Darpan1012/16-channel-manual-variable-power-supply-circuit/README.md

16 channel 0-15 V dual supply power source circuit
