Darpan1012/16-channel-manual-variable-power-supply-circuit/Schematic/GBR_10043463_1_bottom.png

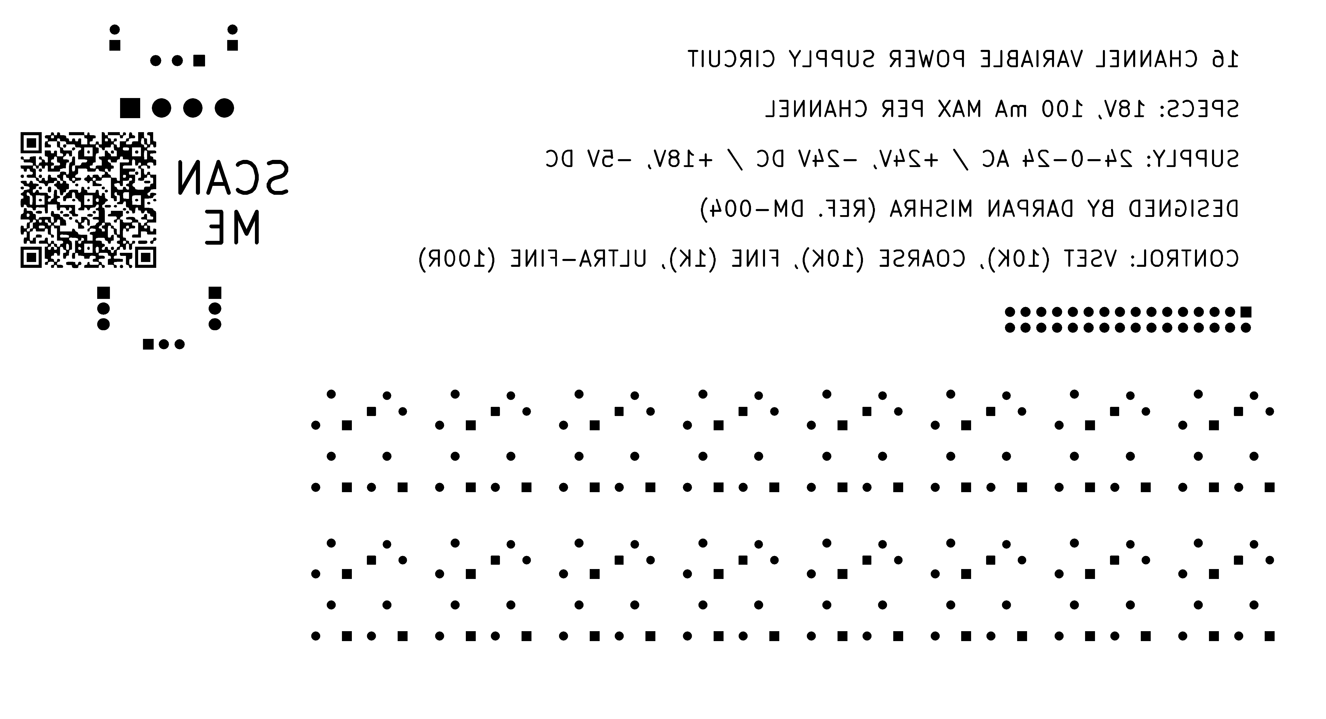
Schematic/GBR_10043463_1_bottom.png
