Darpan1012/16-channel-manual-variable-power-supply-circuit/Schematic/power supply circuit schematic.PNG

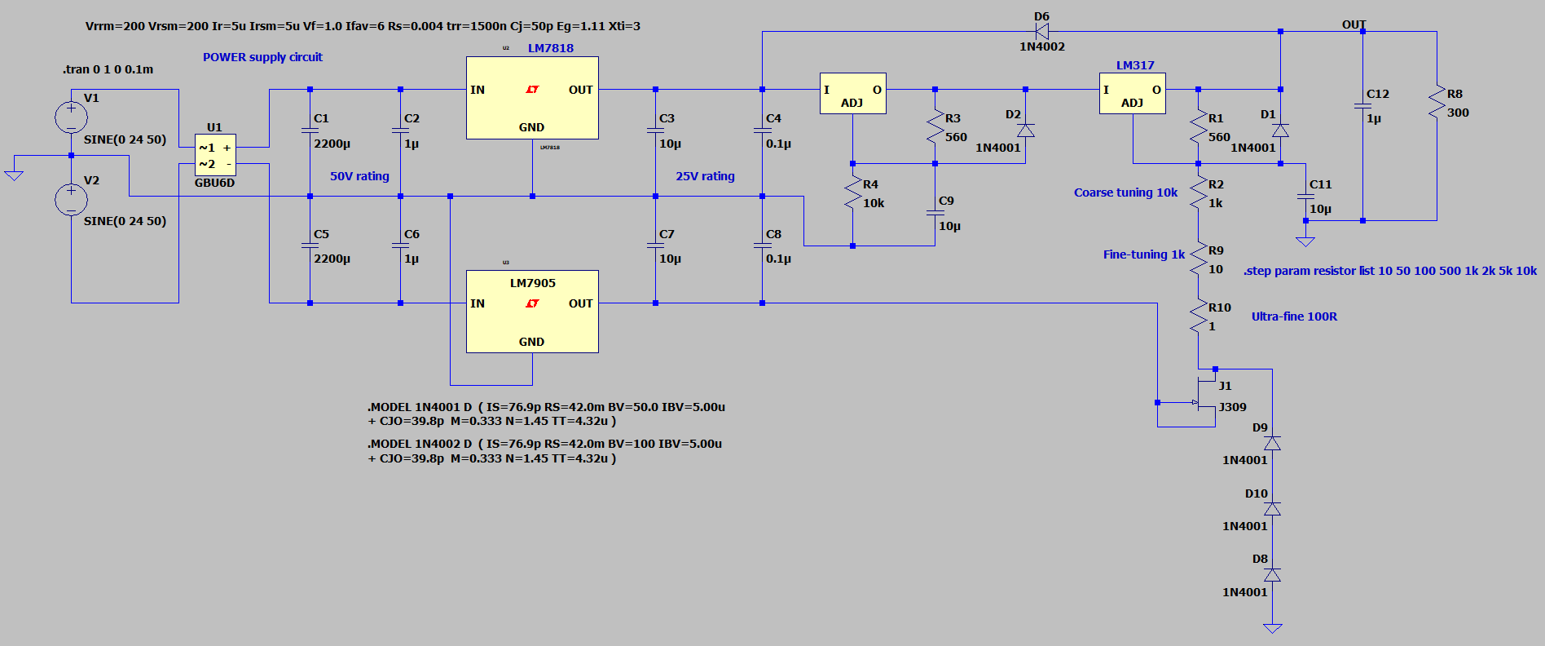
Schematic/power supply circuit schematic.PNG
