Darpan1012/16-channel-manual-variable-power-supply-circuit/Schematic/Snapshot.png

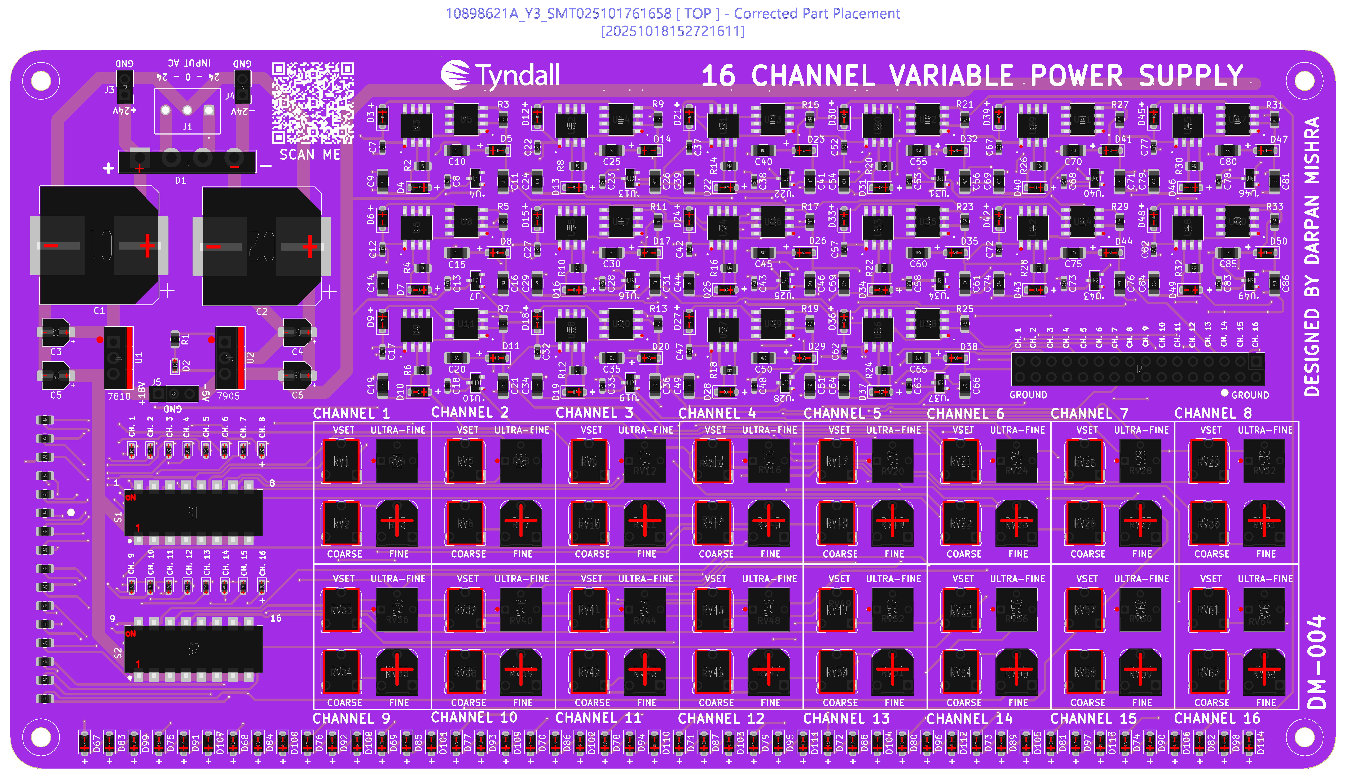
Schematic/Snapshot.png
