Darpan1012/16-channel-manual-variable-power-supply-circuit/SPICE/Power source circuit.asc

C1: cap; 2200µ; V=50 Irms=1.53 Rser=0.037 Lser=0 mfg="Nichicon" pn="UPR1H222MRH" type="Al electrolytic"
C2: cap; 1µ; V=50 Irms=0 Rser=0.0444 Lser=799p mfg="Würth Elektronik" pn="885012209047 WCAP-CSGP 1210" type="X7R"
C3: cap; 10µ; V=25 Irms=23m Rser=1.95 Lser=70f mfg="Würth Elektronik" pn="865230440002 WCAP-AS5H 4.3x4.3" type="Al electrolytic"
C4: cap; 0.1µ; V=25 Irms=0 Rser=0.0287 Lser=150p mfg="Würth Elektronik" pn="885012104005 WCAP-CSGP 0201" type="X5R"
C5: cap; 2200µ; V=50 Irms=1.53 Rser=0.037 Lser=0 mfg="Nichicon" pn="UPR1H222MRH" type="Al electrolytic"
C6: cap; 1µ; V=50 Irms=0 Rser=0.0444 Lser=799p mfg="Würth Elektronik" pn="885012209047 WCAP-CSGP 1210" type="X7R"
C7: cap; 10µ; V=25 Irms=23m Rser=1.95 Lser=70f mfg="Würth Elektronik" pn="865230440002 WCAP-AS5H 4.3x4.3" type="Al electrolytic"
C8: cap; 0.1µ; V=25 Irms=0 Rser=0.0287 Lser=150p mfg="Würth Elektronik" pn="885012104005 WCAP-CSGP 0201" type="X5R"
C9: cap; 10µ; V=25 Irms=23m Rser=1.95 Lser=70f mfg="Würth Elektronik" pn="865230440002 WCAP-AS5H 4.3x4.3" type="Al electrolytic"
C11: cap; 10µ; V=25 Irms=23m Rser=1.95 Lser=70f mfg="Würth Elektronik" pn="865230440002 WCAP-AS5H 4.3x4.3" type="Al electrolytic"
C12: cap; 1µ; V=25 Irms=0 Rser=0.014 Lser=1000p mfg="Würth Elektronik" pn="885012210012 WCAP-CSGP 1812" type="X7R"
D1: diode; 1N4001
D2: diode; 1N4001
D6: diode; 1N4002
D8: diode; 1N4001
D9: diode; 1N4001
D10: diode; 1N4001
J1: njf; J309
R1: res; 560
R2: res; 1k
R3: res; 560
R4: res; 10k
R8: res; 300
R9: res; 10
R10: res; 1
U1: gbu6d
U2: 7818
U3: 7905
U4: LM317
U5: LM317
V1: voltage; SINE(0 24 50)
V2: voltage; SINE(0 24 50)
Named nets: 0, OUT
LM7818
.tran 0 1 0 0.1m
50V rating
25V rating
POWER supply circuit
.MODEL 1N4001 D  ( IS=76.9p RS=42.0m BV=50.0 IBV=5.00u
+ CJO=39.8p  M=0.333 N=1.45 TT=4.32u )
.MODEL 1N4002 D  ( IS=76.9p RS=42.0m BV=100 IBV=5.00u
+ CJO=39.8p  M=0.333 N=1.45 TT=4.32u )
.step param resistor list 10 50 100 500 1k 2k 5k 10k
LM317
Fine-tuning 1k
Ultra-fine 100R
Coarse tuning 10k
