Darpan1012/16-channel-manual-variable-power-supply-circuit/Kicad/power_source_16_ch_manual_ver_4.kicad_pcb

## KiCad design Kicad/power_source_16_ch_manual_ver_4.kicad_pcb (2025-11-14)

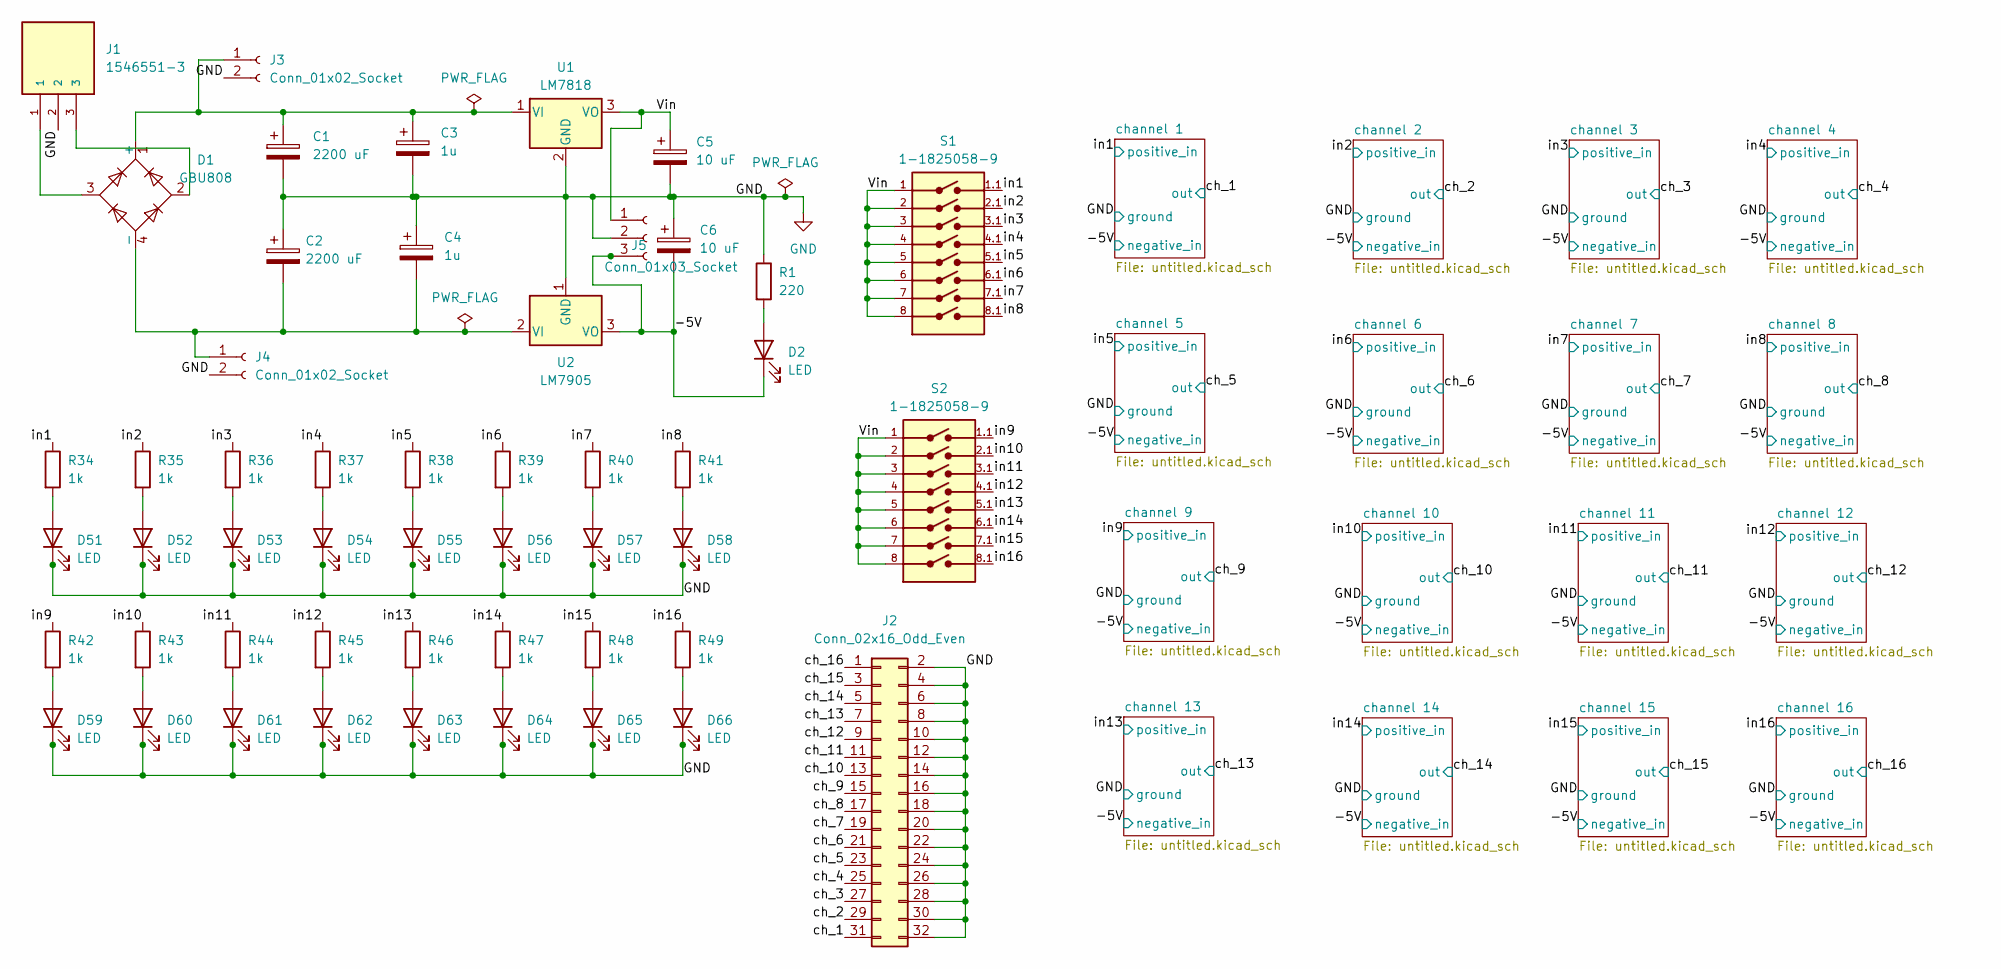
[picture p6: schematic power_source_16_ch_manual_ver_4.kicad_sch, 16 channel manual driver (0-15V)]

Parts:
C1, C2: 2200 uF; CP_Elec_18x17.5; Part Number VE-222M1VTR-1816; LCSC PN C249505
C3, C4: 1u; CP_Elec_4x5.4; Part Number RVT1H1R0M0405; LCSC PN C3348
C5, C6: 10 uF; CP_Elec_4x5.4; Part Number RVT1E100M0405; LCSC PN C3343
D1: GBU808; Diode_Bridge_Vishay_GBU; Part Number GBU808; LCSC PN C3072
D2, D51, D52, D53, D54, D55, D56, D57, D58, D59, D60, D61, D62, D63, D64, D65, D66: LED; LED_0603_1608Metric; Part Number KT-0603R; LCSC PN C2286
J1: 1546551-3; TE_1546551-3; PARTREV R
J2: Conn_02x16_Odd_Even; PinHeader_2x16_P2.54mm_Vertical; Part Number DS1023-2*16SF11; LCSC PN C132130
J3, J4: Conn_01x02_Socket; PinHeader_1x02_P2.54mm_Vertical; Part Number DS1023-1x2SF11; LCSC PN C7509512
J5: Conn_01x03_Socket; PinHeader_1x03_P2.54mm_Vertical; Part Number DS1023-1x3SF11; LCSC PN C7509516
R1: 220; R_0805_2012Metric; Part Number 0805W8F2200T5E; LCSC PN C17557
R34, R35, R36, R37, R38, R39, R40, R41, R42, R43, R44, R45, R46, R47, R48, R49: 1k; R_0805_2012Metric; Part Number 0805W8F1001T5E; LCSC PN C17513
S1, S2: 1-1825058-9; SW_1-1825058-9; PARTREV S4; LCSC PN C266184
U1: LM7818; TO-220-3_Vertical; Part Number L7818CV-DG; LCSC PN C15411
U2: LM7905; TO-220-3_Vertical; Part Number L7905CV-DG; LCSC PN C3799

Connections:
/-5V: C6.2, D2.1 (K), J5.3, U2.3 (VO); also elsewhere on the board
/Vin: C5.1, J5.1, S1.1, S1.2, S1.3, S1.4, S1.5, S1.6, S1.7, S1.8, S2.1, S2.2, S2.3, S2.4, S2.5, S2.6, S2.7, S2.8, U1.3 (VO)
/ch_1: J2.31; also elsewhere on the board
/ch_2: J2.29; also elsewhere on the board
/ch_3: J2.27; also elsewhere on the board
/ch_4: J2.25; also elsewhere on the board
/ch_5: J2.23; also elsewhere on the board
/ch_6: J2.21; also elsewhere on the board
/ch_7: J2.19; also elsewhere on the board
/ch_8: J2.17; also elsewhere on the board
/ch_9: J2.15; also elsewhere on the board
/ch_10: J2.13; also elsewhere on the board
/ch_11: J2.11; also elsewhere on the board
/ch_12: J2.9; also elsewhere on the board
/ch_13: J2.7; also elsewhere on the board
/ch_14: J2.5; also elsewhere on the board
/ch_15: J2.3; also elsewhere on the board
/ch_16: J2.1; also elsewhere on the board
/in1: R34.1, S1.1.1; also elsewhere on the board
/in2: R35.1, S1.2.1; also elsewhere on the board
/in3: R36.1, S1.3.1; also elsewhere on the board
/in4: R37.1, S1.4.1; also elsewhere on the board
/in5: R38.1, S1.5.1; also elsewhere on the board
/in6: R39.1, S1.6.1; also elsewhere on the board
/in7: R40.1, S1.7.1; also elsewhere on the board
/in8: R41.1, S1.8.1; also elsewhere on the board
/in9: R42.1, S2.1.1; also elsewhere on the board
/in10: R43.1, S2.2.1; also elsewhere on the board
/in11: R44.1, S2.3.1; also elsewhere on the board
/in12: R45.1, S2.4.1; also elsewhere on the board
/in13: R46.1, S2.5.1; also elsewhere on the board
/in14: R47.1, S2.6.1; also elsewhere on the board
/in15: R48.1, S2.7.1; also elsewhere on the board
/in16: R49.1, S2.8.1; also elsewhere on the board
GND: C1.2, C2.1, C3.2, C4.1, C5.2, C6.1, D51.1 (K), D52.1 (K), D53.1 (K), D54.1 (K), D55.1 (K), D56.1 (K), D57.1 (K), D58.1 (K), D59.1 (K), D60.1 (K), D61.1 (K), D62.1 (K), D63.1 (K), D64.1 (K), D65.1 (K), D66.1 (K), J1.2, J2.2, J2.4, J2.6, J2.8, J2.10, J2.12, J2.14, J2.16, J2.18, J2.20, J2.22, J2.24, J2.26, J2.28, J2.30, J2.32, J3.2, J4.2, J5.2, R1.1, U1.2 (GND), U2.1 (GND); also elsewhere on the board
unnamed: C1.1, C3.1, D1.1 (+), J3.1, U1.1 (VI)
unnamed: C2.2, C4.2, D1.4 (-), J4.1, U2.2 (VI)
unnamed: D1.2, J1.3
unnamed: D1.3, J1.1
unnamed: D2.2 (A), R1.2
unnamed: D51.2 (A), R34.2
unnamed: D52.2 (A), R35.2
unnamed: D53.2 (A), R36.2
unnamed: D54.2 (A), R37.2
unnamed: D55.2 (A), R38.2
unnamed: D56.2 (A), R39.2
unnamed: D57.2 (A), R40.2
unnamed: D58.2 (A), R41.2
unnamed: D59.2 (A), R42.2
unnamed: D60.2 (A), R43.2
unnamed: D61.2 (A), R44.2
unnamed: D62.2 (A), R45.2
unnamed: D63.2 (A), R46.2
unnamed: D64.2 (A), R47.2
unnamed: D65.2 (A), R48.2
unnamed: D66.2 (A), R49.2

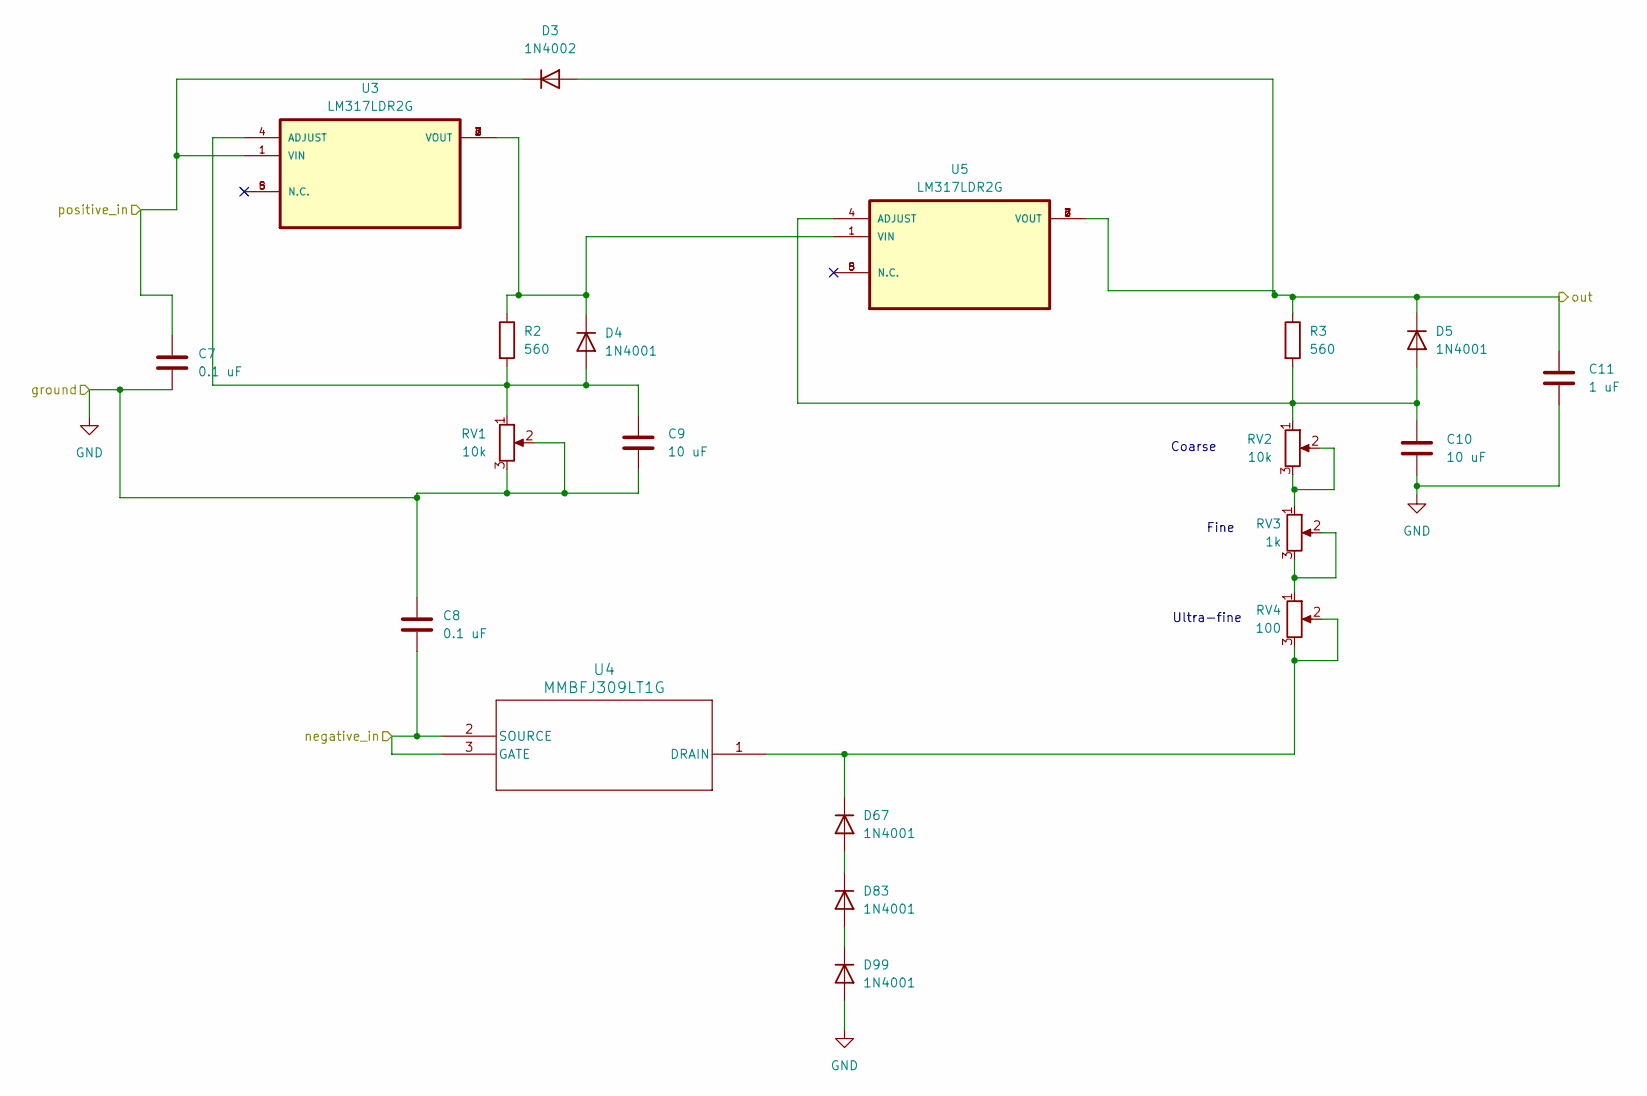
[picture p7: schematic untitled.kicad_sch, channel]

Parts:
C7, C8: 0.1 uF; C_0603_1608Metric; Part Number CC0603KRX7R9BB104; LCSC PN C14663
C9, C10: 10 uF; C_1206_3216Metric; Part Number CL31A106KBHNNNE; LCSC PN C13585
C11: 1 uF; C_1206_3216Metric; Part Number CL31B105KBHNNNE; LCSC PN C1848
D3: 1N4002; D_SOD-123F; Part Number 1N4002W; LCSC PN C169542
D4, D5, D67, D83, D99: 1N4001; D_SOD-123F; Part Number 1N4001W; LCSC PN C162732
R2, R3: 560; R_0805_2012Metric; Part Number 0805W8F5600T5E; LCSC PN C28636
RV1, RV2: 10k; Potentiometer_Runtron_RM-065_Vertical; Part Number WH06-2C-103(10K); LCSC PN C5205043
RV3: 1k; Potentiometer_Runtron_RM-065_Vertical; Part Number WH06-2C-102(1K); LCSC PN C5205040
RV4: 100; TRIM_3362P-1-103; Part Number 3362P-1-101; LCSC PN C118959
U3, U5: LM317LDR2G; SOIC127P600X175-8N; Part Number LM317LD13TR; LCSC PN C81457
U4: MMBFJ309LT1G; SOT-23_ONS-L; Part Number MMBFJ309LT1G; LCSC PN C58012

Connections:
/-5V: C8.2, U4.2 (SOURCE), U4.3 (GATE); also elsewhere on the board
/ch_1: C11.1, D3.2 (A), D5.1 (K), R3.1, U5.2 (VOUT), U5.3 (VOUT), U5.6 (VOUT), U5.7 (VOUT); also elsewhere on the board
/in1: C7.1, D3.1 (K), U3.1 (VIN); also elsewhere on the board
GND: C7.2, C8.1, C9.2, C10.2, C11.2, D99.2 (A), RV1.2, RV1.3; also elsewhere on the board
unnamed: C9.1, D4.2 (A), R2.2, RV1.1, U3.4 (ADJUST)
unnamed: D4.1 (K), R2.1, U3.2 (VOUT), U3.3 (VOUT), U3.6 (VOUT), U3.7 (VOUT), U5.1 (VIN)
unnamed: C10.1, D5.2 (A), R3.2, RV2.1, U5.4 (ADJUST)
unnamed: D67.2 (A), D83.1 (K)
unnamed: D67.1 (K), RV4.2, RV4.3, U4.1 (DRAIN)
unnamed: D83.2 (A), D99.1 (K)
unnamed: RV2.2, RV2.3, RV3.1
unnamed: RV3.2, RV3.3, RV4.1

Parts of its further copies:
C12, C13, C17, C18, C22, C23, C27, C28, C32, C33, C37, C38, C42, C43, C47, C48, C52, C53, C57, C58, C62, C63, C67, C68, C72, C73, C77, C78, C82, C83: 0.1 uF; C_0603_1608Metric; Part Number CC0603KRX7R9BB104; LCSC PN C14663
C14, C15, C19, C20, C24, C25, C29, C30, C34, C35, C39, C40, C44, C45, C49, C50, C54, C55, C59, C60, C64, C65, C69, C70, C74, C75, C79, C80, C84, C85: 10 uF; C_1206_3216Metric; Part Number CL31A106KBHNNNE; LCSC PN C13585
C16, C21, C26, C31, C36, C41, C46, C51, C56, C61, C66, C71, C76, C81, C86: 1 uF; C_1206_3216Metric; Part Number CL31B105KBHNNNE; LCSC PN C1848
D6, D9, D12, D15, D18, D21, D24, D27, D30, D33, D36, D39, D42, D45, D48: 1N4002; D_SOD-123F; Part Number 1N4002W; LCSC PN C169542
D7, D8, D10, D11, D13, D14, D16, D17, D19, D20, D22, D23, D25, D26, D28, D29, D31, D32, D34, D35, D37, D38, D40, D41, D43, D44, D46, D47, D49, D50, D68, D69, D70, D71, D72, D73, D74, D75, D76, D77, D78, D79, D80, D81, D82, D84, D85, D86, D87, D88, D89, D90, D91, D92, D93, D94, D95, D96, D97, D98, D100, D101, D102, D103, D104, D105, D106, D107, D108, D109, D110, D111, D112, D113, D114: 1N4001; D_SOD-123F; Part Number 1N4001W; LCSC PN C162732
R4, R5, R6, R7, R8, R9, R10, R11, R12, R13, R14, R15, R16, R17, R18, R19, R20, R21, R22, R23, R24, R25, R26, R27, R28, R29, R30, R31, R32, R33: 560; R_0805_2012Metric; Part Number 0805W8F5600T5E; LCSC PN C28636
RV5, RV6, RV9, RV10, RV13, RV14, RV17, RV18, RV21, RV22, RV25, RV26, RV29, RV30, RV33, RV34, RV37, RV38, RV41, RV42, RV45, RV46, RV49, RV50, RV53, RV54, RV57, RV58, RV61, RV62: 10k; Potentiometer_Runtron_RM-065_Vertical; Part Number WH06-2C-103(10K); LCSC PN C5205043
RV7, RV11, RV15, RV19, RV23, RV27, RV31, RV35, RV39, RV43, RV47, RV51, RV55, RV59, RV63: 1k; Potentiometer_Runtron_RM-065_Vertical; Part Number WH06-2C-102(1K); LCSC PN C5205040
RV8, RV12, RV16, RV20, RV24, RV28, RV32, RV36, RV40, RV44, RV48, RV52, RV56, RV60, RV64: 100; TRIM_3362P-1-103; Part Number 3362P-1-101; LCSC PN C118959
U6, U8, U9, U11, U12, U14, U15, U17, U18, U20, U21, U23, U24, U26, U27, U29, U30, U32, U33, U35, U36, U38, U39, U41, U42, U44, U45, U47, U48, U50: LM317LDR2G; SOIC127P600X175-8N; Part Number LM317LD13TR; LCSC PN C81457
U7, U10, U13, U16, U19, U22, U25, U28, U31, U34, U37, U40, U43, U46, U49: MMBFJ309LT1G; SOT-23_ONS-L; Part Number MMBFJ309LT1G; LCSC PN C58012

Connections of its further copies:
/-5V: C13.2, C18.2, C23.2, C28.2, C33.2, C38.2, C43.2, C48.2, C53.2, C58.2, C63.2, C68.2, C73.2, C78.2, C83.2, U7.2 (SOURCE), U7.3 (GATE), U10.2 (SOURCE), U10.3 (GATE), U13.2 (SOURCE), U13.3 (GATE), U16.2 (SOURCE), U16.3 (GATE), U19.2 (SOURCE), U19.3 (GATE), U22.2 (SOURCE), U22.3 (GATE), U25.2 (SOURCE), U25.3 (GATE), U28.2 (SOURCE), U28.3 (GATE), U31.2 (SOURCE), U31.3 (GATE), U34.2 (SOURCE), U34.3 (GATE), U37.2 (SOURCE), U37.3 (GATE), U40.2 (SOURCE), U40.3 (GATE), U43.2 (SOURCE), U43.3 (GATE), U46.2 (SOURCE), U46.3 (GATE), U49.2 (SOURCE), U49.3 (GATE); also elsewhere on the board
/ch_2: C16.1, D6.2 (A), D8.1 (K), R5.1, U8.2 (VOUT), U8.3 (VOUT), U8.6 (VOUT), U8.7 (VOUT); also elsewhere on the board
/ch_3: C21.1, D9.2 (A), D11.1 (K), R7.1, U11.2 (VOUT), U11.3 (VOUT), U11.6 (VOUT), U11.7 (VOUT); also elsewhere on the board
/ch_4: C26.1, D12.2 (A), D14.1 (K), R9.1, U14.2 (VOUT), U14.3 (VOUT), U14.6 (VOUT), U14.7 (VOUT); also elsewhere on the board
/ch_5: C31.1, D15.2 (A), D17.1 (K), R11.1, U17.2 (VOUT), U17.3 (VOUT), U17.6 (VOUT), U17.7 (VOUT); also elsewhere on the board
/ch_6: C36.1, D18.2 (A), D20.1 (K), R13.1, U20.2 (VOUT), U20.3 (VOUT), U20.6 (VOUT), U20.7 (VOUT); also elsewhere on the board
/ch_7: C41.1, D21.2 (A), D23.1 (K), R15.1, U23.2 (VOUT), U23.3 (VOUT), U23.6 (VOUT), U23.7 (VOUT); also elsewhere on the board
/ch_8: C46.1, D24.2 (A), D26.1 (K), R17.1, U26.2 (VOUT), U26.3 (VOUT), U26.6 (VOUT), U26.7 (VOUT); also elsewhere on the board
/ch_9: C51.1, D27.2 (A), D29.1 (K), R19.1, U29.2 (VOUT), U29.3 (VOUT), U29.6 (VOUT), U29.7 (VOUT); also elsewhere on the board
/ch_10: C56.1, D30.2 (A), D32.1 (K), R21.1, U32.2 (VOUT), U32.3 (VOUT), U32.6 (VOUT), U32.7 (VOUT); also elsewhere on the board
/ch_11: C61.1, D33.2 (A), D35.1 (K), R23.1, U35.2 (VOUT), U35.3 (VOUT), U35.6 (VOUT), U35.7 (VOUT); also elsewhere on the board
/ch_12: C66.1, D36.2 (A), D38.1 (K), R25.1, U38.2 (VOUT), U38.3 (VOUT), U38.6 (VOUT), U38.7 (VOUT); also elsewhere on the board
/ch_13: C71.1, D39.2 (A), D41.1 (K), R27.1, U41.2 (VOUT), U41.3 (VOUT), U41.6 (VOUT), U41.7 (VOUT); also elsewhere on the board
/ch_14: C76.1, D42.2 (A), D44.1 (K), R29.1, U44.2 (VOUT), U44.3 (VOUT), U44.6 (VOUT), U44.7 (VOUT); also elsewhere on the board
/ch_15: C81.1, D45.2 (A), D47.1 (K), R31.1, U47.2 (VOUT), U47.3 (VOUT), U47.6 (VOUT), U47.7 (VOUT); also elsewhere on the board
/ch_16: C86.1, D48.2 (A), D50.1 (K), R33.1, U50.2 (VOUT), U50.3 (VOUT), U50.6 (VOUT), U50.7 (VOUT); also elsewhere on the board
/in2: C12.1, D6.1 (K), U6.1 (VIN); also elsewhere on the board
/in3: C17.1, D9.1 (K), U9.1 (VIN); also elsewhere on the board
/in4: C22.1, D12.1 (K), U12.1 (VIN); also elsewhere on the board
/in5: C27.1, D15.1 (K), U15.1 (VIN); also elsewhere on the board
/in6: C32.1, D18.1 (K), U18.1 (VIN); also elsewhere on the board
/in7: C37.1, D21.1 (K), U21.1 (VIN); also elsewhere on the board
/in8: C42.1, D24.1 (K), U24.1 (VIN); also elsewhere on the board
/in9: C47.1, D27.1 (K), U27.1 (VIN); also elsewhere on the board
/in10: C52.1, D30.1 (K), U30.1 (VIN); also elsewhere on the board
/in11: C57.1, D33.1 (K), U33.1 (VIN); also elsewhere on the board
/in12: C62.1, D36.1 (K), U36.1 (VIN); also elsewhere on the board
/in13: C67.1, D39.1 (K), U39.1 (VIN); also elsewhere on the board
/in14: C72.1, D42.1 (K), U42.1 (VIN); also elsewhere on the board
/in15: C77.1, D45.1 (K), U45.1 (VIN); also elsewhere on the board
/in16: C82.1, D48.1 (K), U48.1 (VIN); also elsewhere on the board
GND: C12.2, C13.1, C14.2, C15.2, C16.2, C17.2, C18.1, C19.2, C20.2, C21.2, C22.2, C23.1, C24.2, C25.2, C26.2, C27.2, C28.1, C29.2, C30.2, C31.2, C32.2, C33.1, C34.2, C35.2, C36.2, C37.2, C38.1, C39.2, C40.2, C41.2, C42.2, C43.1, C44.2, C45.2, C46.2, C47.2, C48.1, C49.2, C50.2, C51.2, C52.2, C53.1, C54.2, C55.2, C56.2, C57.2, C58.1, C59.2, C60.2, C61.2, C62.2, C63.1, C64.2, C65.2, C66.2, C67.2, C68.1, C69.2, C70.2, C71.2, C72.2, C73.1, C74.2, C75.2, C76.2, C77.2, C78.1, C79.2, C80.2, C81.2, C82.2, C83.1, C84.2, C85.2, C86.2, D100.2 (A), D101.2 (A), D102.2 (A), D103.2 (A), D104.2 (A), D105.2 (A), D106.2 (A), D107.2 (A), D108.2 (A), D109.2 (A), D110.2 (A), D111.2 (A), D112.2 (A), D113.2 (A), D114.2 (A), RV5.2, RV5.3, RV9.2, RV9.3, RV13.2, RV13.3, RV17.2, RV17.3, RV21.2, RV21.3, RV25.2, RV25.3, RV29.2, RV29.3, RV33.2, RV33.3, RV37.2, RV37.3, RV41.2, RV41.3, RV45.2, RV45.3, RV49.2, RV49.3, RV53.2, RV53.3, RV57.2, RV57.3, RV61.2, RV61.3; also elsewhere on the board
unnamed: C14.1, D7.2 (A), R4.2, RV5.1, U6.4 (ADJUST)
unnamed: D7.1 (K), R4.1, U6.2 (VOUT), U6.3 (VOUT), U6.6 (VOUT), U6.7 (VOUT), U8.1 (VIN)
unnamed: C15.1, D8.2 (A), R5.2, RV6.1, U8.4 (ADJUST)
unnamed: C19.1, D10.2 (A), R6.2, RV9.1, U9.4 (ADJUST)
unnamed: D10.1 (K), R6.1, U9.2 (VOUT), U9.3 (VOUT), U9.6 (VOUT), U9.7 (VOUT), U11.1 (VIN)
unnamed: C20.1, D11.2 (A), R7.2, RV10.1, U11.4 (ADJUST)
unnamed: C24.1, D13.2 (A), R8.2, RV13.1, U12.4 (ADJUST)
unnamed: D13.1 (K), R8.1, U12.2 (VOUT), U12.3 (VOUT), U12.6 (VOUT), U12.7 (VOUT), U14.1 (VIN)
unnamed: C25.1, D14.2 (A), R9.2, RV14.1, U14.4 (ADJUST)
unnamed: C29.1, D16.2 (A), R10.2, RV17.1, U15.4 (ADJUST)
unnamed: D16.1 (K), R10.1, U15.2 (VOUT), U15.3 (VOUT), U15.6 (VOUT), U15.7 (VOUT), U17.1 (VIN)
unnamed: C30.1, D17.2 (A), R11.2, RV18.1, U17.4 (ADJUST)
unnamed: C34.1, D19.2 (A), R12.2, RV21.1, U18.4 (ADJUST)
unnamed: D19.1 (K), R12.1, U18.2 (VOUT), U18.3 (VOUT), U18.6 (VOUT), U18.7 (VOUT), U20.1 (VIN)
unnamed: C35.1, D20.2 (A), R13.2, RV22.1, U20.4 (ADJUST)
unnamed: C39.1, D22.2 (A), R14.2, RV25.1, U21.4 (ADJUST)
unnamed: D22.1 (K), R14.1, U21.2 (VOUT), U21.3 (VOUT), U21.6 (VOUT), U21.7 (VOUT), U23.1 (VIN)
unnamed: C40.1, D23.2 (A), R15.2, RV26.1, U23.4 (ADJUST)
unnamed: C44.1, D25.2 (A), R16.2, RV29.1, U24.4 (ADJUST)
unnamed: D25.1 (K), R16.1, U24.2 (VOUT), U24.3 (VOUT), U24.6 (VOUT), U24.7 (VOUT), U26.1 (VIN)
unnamed: C45.1, D26.2 (A), R17.2, RV30.1, U26.4 (ADJUST)
unnamed: C49.1, D28.2 (A), R18.2, RV33.1, U27.4 (ADJUST)
unnamed: D28.1 (K), R18.1, U27.2 (VOUT), U27.3 (VOUT), U27.6 (VOUT), U27.7 (VOUT), U29.1 (VIN)
unnamed: C50.1, D29.2 (A), R19.2, RV34.1, U29.4 (ADJUST)
unnamed: C54.1, D31.2 (A), R20.2, RV37.1, U30.4 (ADJUST)
unnamed: D31.1 (K), R20.1, U30.2 (VOUT), U30.3 (VOUT), U30.6 (VOUT), U30.7 (VOUT), U32.1 (VIN)
unnamed: C55.1, D32.2 (A), R21.2, RV38.1, U32.4 (ADJUST)
unnamed: C59.1, D34.2 (A), R22.2, RV41.1, U33.4 (ADJUST)
unnamed: D34.1 (K), R22.1, U33.2 (VOUT), U33.3 (VOUT), U33.6 (VOUT), U33.7 (VOUT), U35.1 (VIN)
unnamed: C60.1, D35.2 (A), R23.2, RV42.1, U35.4 (ADJUST)
unnamed: C64.1, D37.2 (A), R24.2, RV45.1, U36.4 (ADJUST)
unnamed: D37.1 (K), R24.1, U36.2 (VOUT), U36.3 (VOUT), U36.6 (VOUT), U36.7 (VOUT), U38.1 (VIN)
unnamed: C65.1, D38.2 (A), R25.2, RV46.1, U38.4 (ADJUST)
unnamed: C69.1, D40.2 (A), R26.2, RV49.1, U39.4 (ADJUST)
unnamed: D40.1 (K), R26.1, U39.2 (VOUT), U39.3 (VOUT), U39.6 (VOUT), U39.7 (VOUT), U41.1 (VIN)
unnamed: C70.1, D41.2 (A), R27.2, RV50.1, U41.4 (ADJUST)
unnamed: C74.1, D43.2 (A), R28.2, RV53.1, U42.4 (ADJUST)
unnamed: D43.1 (K), R28.1, U42.2 (VOUT), U42.3 (VOUT), U42.6 (VOUT), U42.7 (VOUT), U44.1 (VIN)
unnamed: C75.1, D44.2 (A), R29.2, RV54.1, U44.4 (ADJUST)
unnamed: C79.1, D46.2 (A), R30.2, RV57.1, U45.4 (ADJUST)
unnamed: D46.1 (K), R30.1, U45.2 (VOUT), U45.3 (VOUT), U45.6 (VOUT), U45.7 (VOUT), U47.1 (VIN)
unnamed: C80.1, D47.2 (A), R31.2, RV58.1, U47.4 (ADJUST)
unnamed: C84.1, D49.2 (A), R32.2, RV61.1, U48.4 (ADJUST)
unnamed: D49.1 (K), R32.1, U48.2 (VOUT), U48.3 (VOUT), U48.6 (VOUT), U48.7 (VOUT), U50.1 (VIN)
unnamed: C85.1, D50.2 (A), R33.2, RV62.1, U50.4 (ADJUST)
unnamed: D68.2 (A), D84.1 (K)
unnamed: D68.1 (K), RV8.2, RV8.3, U7.1 (DRAIN)
unnamed: D69.2 (A), D85.1 (K)
unnamed: D69.1 (K), RV12.2, RV12.3, U10.1 (DRAIN)
unnamed: D70.2 (A), D86.1 (K)
unnamed: D70.1 (K), RV16.2, RV16.3, U13.1 (DRAIN)
unnamed: D71.2 (A), D87.1 (K)
unnamed: D71.1 (K), RV20.2, RV20.3, U16.1 (DRAIN)
unnamed: D72.2 (A), D88.1 (K)
unnamed: D72.1 (K), RV24.2, RV24.3, U19.1 (DRAIN)
unnamed: D73.2 (A), D89.1 (K)
unnamed: D73.1 (K), RV28.2, RV28.3, U22.1 (DRAIN)
unnamed: D74.2 (A), D90.1 (K)
unnamed: D74.1 (K), RV32.2, RV32.3, U25.1 (DRAIN)
unnamed: D75.2 (A), D91.1 (K)
unnamed: D75.1 (K), RV36.2, RV36.3, U28.1 (DRAIN)
unnamed: D76.2 (A), D92.1 (K)
unnamed: D76.1 (K), RV40.2, RV40.3, U31.1 (DRAIN)
unnamed: D77.2 (A), D93.1 (K)
unnamed: D77.1 (K), RV44.2, RV44.3, U34.1 (DRAIN)
unnamed: D78.2 (A), D94.1 (K)
unnamed: D78.1 (K), RV48.2, RV48.3, U37.1 (DRAIN)
unnamed: D79.2 (A), D95.1 (K)
unnamed: D79.1 (K), RV52.2, RV52.3, U40.1 (DRAIN)
unnamed: D80.2 (A), D96.1 (K)
unnamed: D80.1 (K), RV56.2, RV56.3, U43.1 (DRAIN)
unnamed: D81.2 (A), D97.1 (K)
unnamed: D81.1 (K), RV60.2, RV60.3, U46.1 (DRAIN)
unnamed: D82.2 (A), D98.1 (K)
unnamed: D82.1 (K), RV64.2, RV64.3, U49.1 (DRAIN)
unnamed: D84.2 (A), D100.1 (K)
unnamed: D85.2 (A), D101.1 (K)
unnamed: D86.2 (A), D102.1 (K)
unnamed: D87.2 (A), D103.1 (K)
unnamed: D88.2 (A), D104.1 (K)
unnamed: D89.2 (A), D105.1 (K)
unnamed: D90.2 (A), D106.1 (K)
unnamed: D91.2 (A), D107.1 (K)
unnamed: D92.2 (A), D108.1 (K)
unnamed: D93.2 (A), D109.1 (K)
unnamed: D94.2 (A), D110.1 (K)
unnamed: D95.2 (A), D111.1 (K)
unnamed: D96.2 (A), D112.1 (K)
unnamed: D97.2 (A), D113.1 (K)
unnamed: D98.2 (A), D114.1 (K)
unnamed: RV6.2, RV6.3, RV7.1
unnamed: RV7.2, RV7.3, RV8.1
unnamed: RV10.2, RV10.3, RV11.1
unnamed: RV11.2, RV11.3, RV12.1
unnamed: RV14.2, RV14.3, RV15.1
unnamed: RV15.2, RV15.3, RV16.1
unnamed: RV18.2, RV18.3, RV19.1
unnamed: RV19.2, RV19.3, RV20.1
unnamed: RV22.2, RV22.3, RV23.1
unnamed: RV23.2, RV23.3, RV24.1
unnamed: RV26.2, RV26.3, RV27.1
unnamed: RV27.2, RV27.3, RV28.1
unnamed: RV30.2, RV30.3, RV31.1
unnamed: RV31.2, RV31.3, RV32.1
unnamed: RV34.2, RV34.3, RV35.1
unnamed: RV35.2, RV35.3, RV36.1
unnamed: RV38.2, RV38.3, RV39.1
unnamed: RV39.2, RV39.3, RV40.1
unnamed: RV42.2, RV42.3, RV43.1
unnamed: RV43.2, RV43.3, RV44.1
unnamed: RV46.2, RV46.3, RV47.1
unnamed: RV47.2, RV47.3, RV48.1
unnamed: RV50.2, RV50.3, RV51.1
unnamed: RV51.2, RV51.3, RV52.1
unnamed: RV54.2, RV54.3, RV55.1
unnamed: RV55.2, RV55.3, RV56.1
unnamed: RV58.2, RV58.3, RV59.1
unnamed: RV59.2, RV59.3, RV60.1
unnamed: RV62.2, RV62.3, RV63.1
unnamed: RV63.2, RV63.3, RV64.1

Notes on the sheet:
Ultra-fine
Fine
Coarse

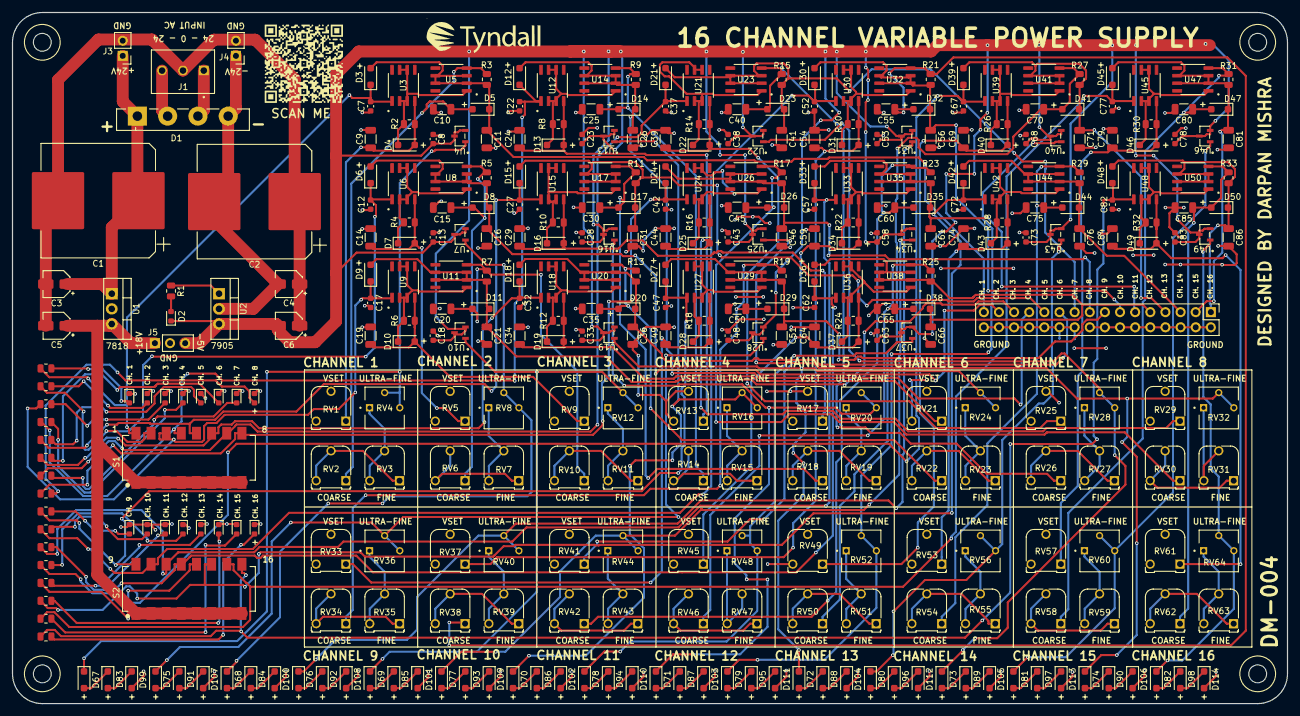
[picture p8: board power_source_16_ch_manual_ver_4.kicad_pcb from above]

Board: 2 copper layers, 214.0 x 116.0 mm, 370 parts (0 on the bottom side), 184 nets.
