Darpan1012/16-channel-manual-variable-power-supply-circuit/(commit log)

2025-11-14 Create Circuit
2025-11-14 Create pcb
2025-11-14 Create gerber
